manakjiri/lora-module-hw/lora-module.kicad_pcb

## KiCad design lora-module.kicad_pcb (2024-03-26)

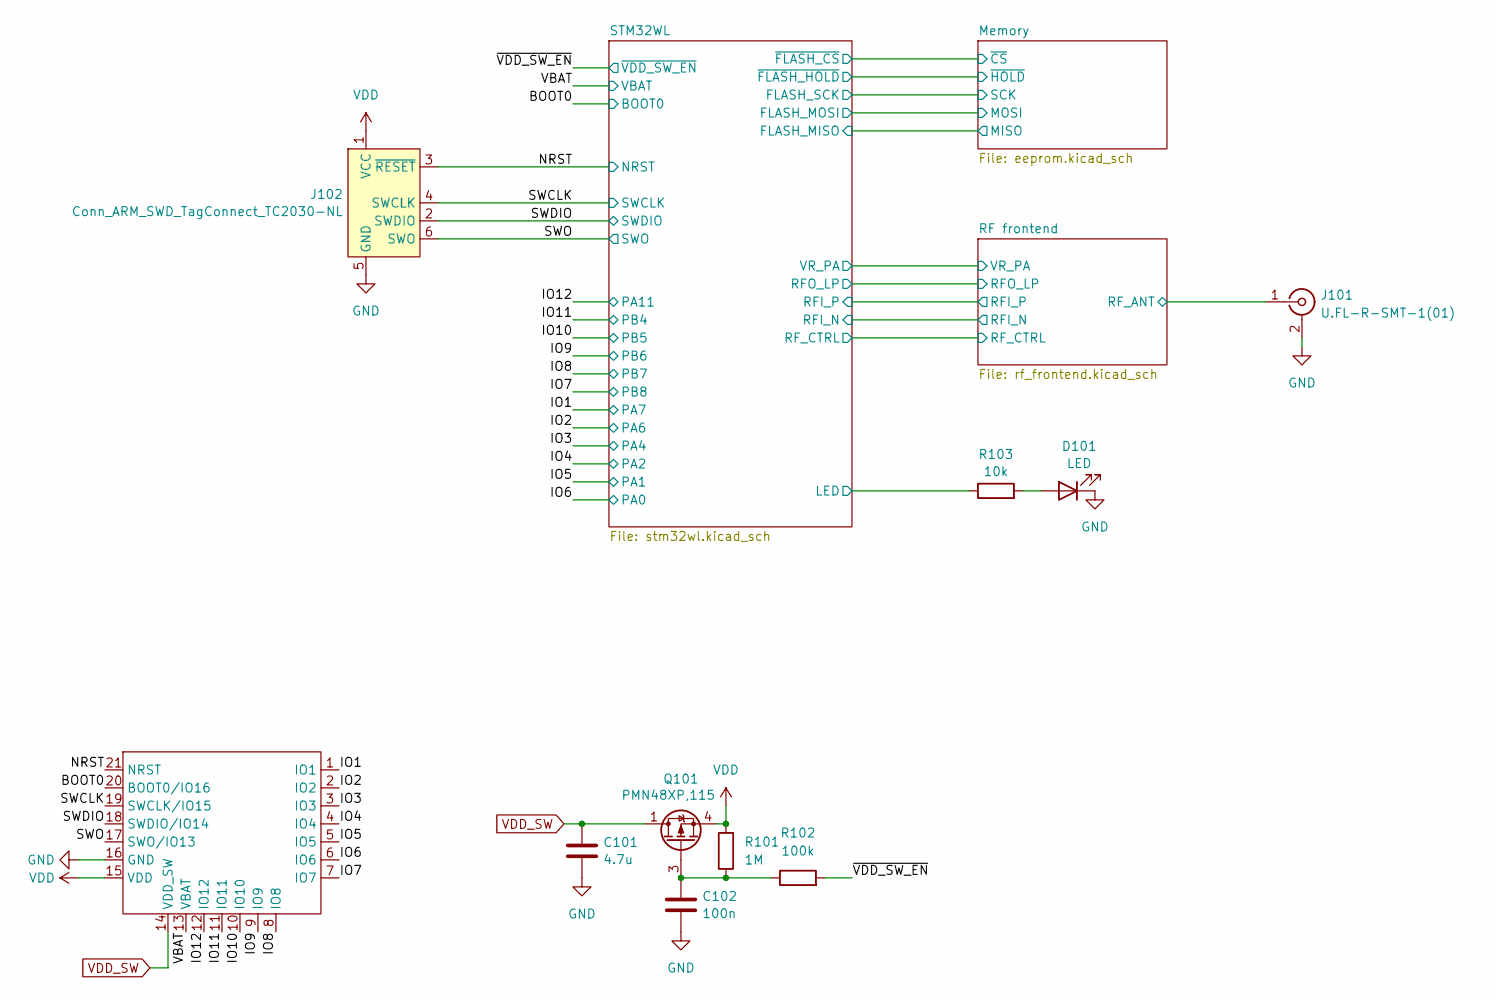
[picture p1: schematic lora-module.kicad_sch]

Parts:
C101: 4.7u; C_0603_1608Metric
C102: 100n; C_0402_1005Metric
D101: LED; LED_0402_1005Metric
J101: U.FL-R-SMT-1(01); U.FL_Hirose_U.FL-R-SMT-1_Vertical
J102: Conn_ARM_SWD_TagConnect_TC2030-NL; Tag-Connect_TC2030-IDC-NL_2x03_P1.27mm_Vertical
J106: module-connectors
Q101: PMN48XP,115; TSOP-6_1.65x3.05mm_P0.95mm
R101: 1M; R_0402_1005Metric
R102: 100k; R_0402_1005Metric
R103: 10k; R_0402_1005Metric

Connections:
/BOOT0: J106.20 (BOOT0/IO16); also elsewhere on the board
/IO1: J106.1 (IO1); also elsewhere on the board
/IO2: J106.2 (IO2); also elsewhere on the board
/IO3: J106.3 (IO3); also elsewhere on the board
/IO4: J106.4 (IO4); also elsewhere on the board
/IO5: J106.5 (IO5); also elsewhere on the board
/IO6: J106.6 (IO6); also elsewhere on the board
/IO7: J106.7 (IO7); also elsewhere on the board
/IO8: J106.8 (IO8); also elsewhere on the board
/IO9: J106.9 (IO9); also elsewhere on the board
/IO10: J106.10 (IO10); also elsewhere on the board
/IO11: J106.11 (IO11); also elsewhere on the board
/IO12: J106.12 (IO12); also elsewhere on the board
/NRST: J102.3 (~RESET), J106.21 (NRST); also elsewhere on the board
/RF frontend/RF_ANT: J101.1 (In); also elsewhere on the board
/STM32WL/LED: R103.1; also elsewhere on the board
/SWCLK: J102.4 (SWCLK), J106.19 (SWCLK/IO15); also elsewhere on the board
/SWDIO: J102.2 (SWDIO), J106.18 (SWDIO/IO14); also elsewhere on the board
/SWO: J102.6 (SWO), J106.17 (SWO/IO13); also elsewhere on the board
/VBAT: J106.13 (VBAT); also elsewhere on the board
/~VDD_SW_EN: R102.2; also elsewhere on the board
GND: C101.2, C102.2, D101.1 (K), J101.2 (Ext), J102.5 (GND), J106.16 (GND); also elsewhere on the board
unnamed: D101.2 (A), R103.2
unnamed: C102.1, Q101.3 (G), R101.1, R102.1
VDD: J102.1 (VCC), J106.15 (VDD), Q101.4 (S), R101.2; also elsewhere on the board
VDD_SW: C101.1, J106.14 (VDD_SW), Q101.1 (D), Q101.2 (D), Q101.5 (D), Q101.6 (D); also elsewhere on the board

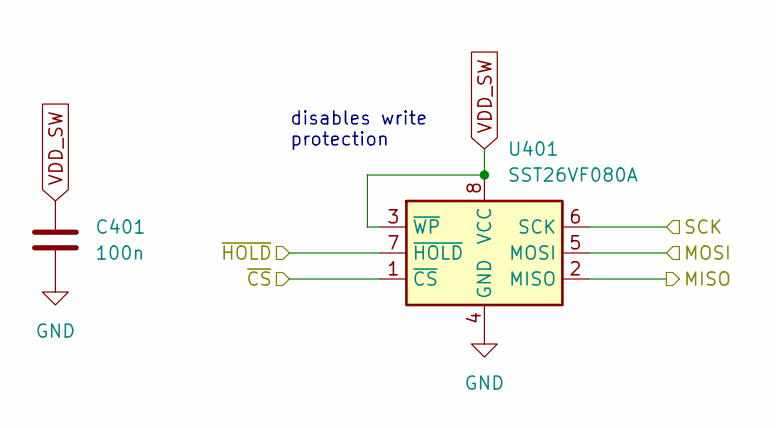
[picture p2: schematic eeprom.kicad_sch]

Parts:
C401: 100n; C_0402_1005Metric
U401: SST26VF080A; WDFN-8-1EP_6x5mm_P1.27mm_EP3.4x4mm

Connections:
/Memory/MISO: U401.2 (MISO); also elsewhere on the board
/Memory/MOSI: U401.5 (MOSI); also elsewhere on the board
/Memory/SCK: U401.6 (SCK); also elsewhere on the board
/Memory/~CS: U401.1 (~CS); also elsewhere on the board
/Memory/~HOLD: U401.7 (~HOLD); also elsewhere on the board
GND: C401.2, U401.4 (GND), U401.9 (GND); also elsewhere on the board
VDD_SW: C401.1, U401.3 (~WP), U401.8 (VCC); also elsewhere on the board

Notes on the sheet:
disables write protection

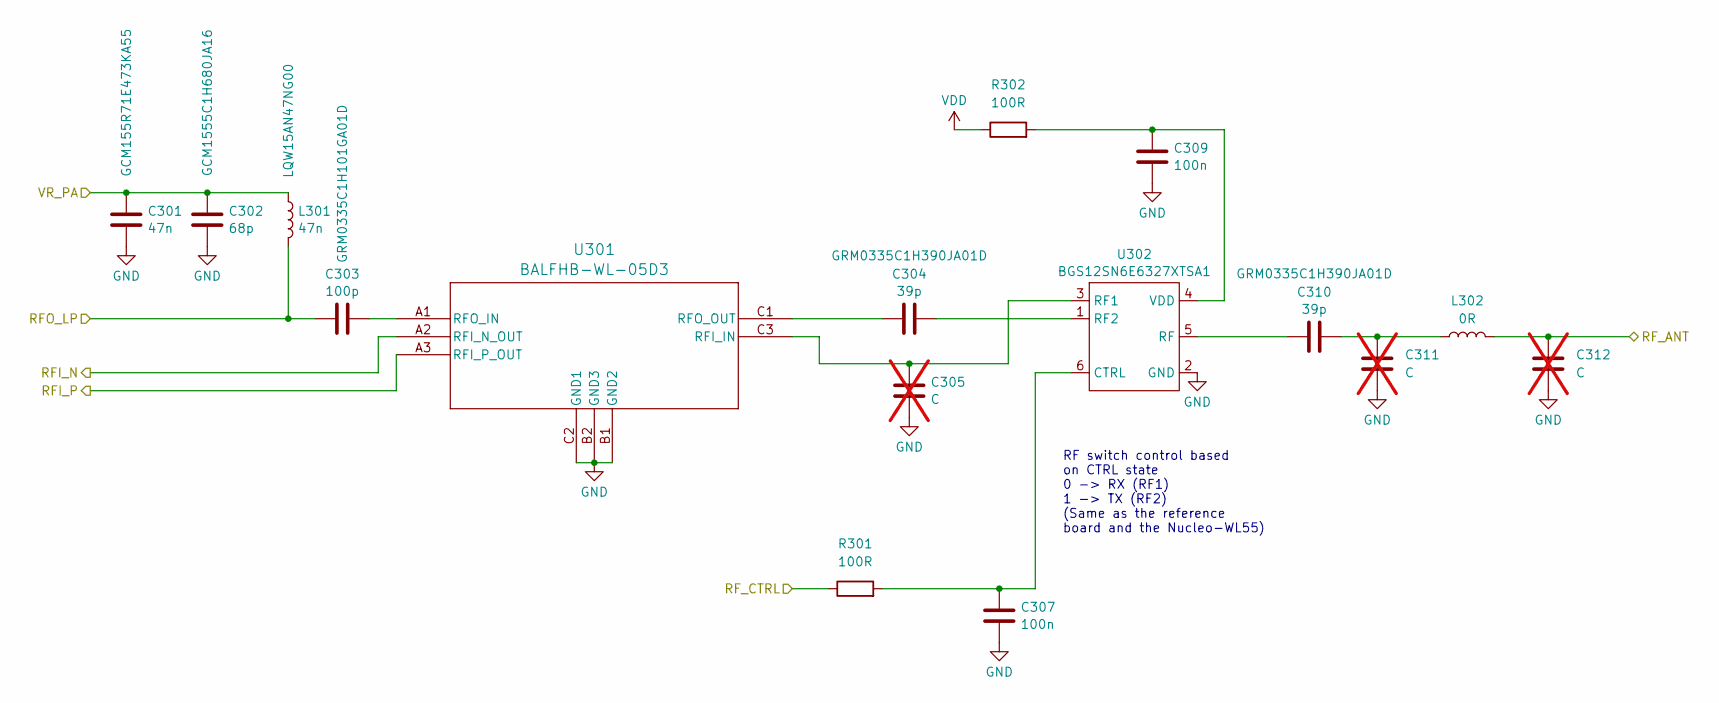
[picture p3: schematic rf_frontend.kicad_sch]

Parts:
C301: 47n; C_0603_1608Metric; Part GCM155R71E473KA55
C302: 68p; C_0402_1005Metric; Part GCM1555C1H680JA16
C303: 100p; C_0402_1005Metric; Part GRM0335C1H101GA01D
C304, C310: 39p; C_0402_1005Metric; Part GRM0335C1H390JA01D
C305, C311, C312: C; C_0402_1005Metric_Pad0.74x0.62mm_HandSolder; not fitted
C307, C309: 100n; C_0402_1005Metric
L301: 47n; L_0402_1005Metric; Part LQW15AN47NG00
L302: 0R; L_0402_1005Metric_Pad0.77x0.64mm_HandSolder
R301, R302: 100R; R_0402_1005Metric
U301: BALFHB-WL-05D3; BGA8_BALFHB_STM
U302: BGS12SN6E6327XTSA1; Infineon_PG-TSNP-6-10_0.7x1.1mm_0.7x1.1mm_P0.4mm

Connections:
/RF frontend/RFI_N: U301.A2 (RFI_N_OUT); also elsewhere on the board
/RF frontend/RFI_P: U301.A3 (RFI_P_OUT); also elsewhere on the board
/RF frontend/RFO_LP: C303.1, L301.2; also elsewhere on the board
/RF frontend/RF_ANT: C312.1, L302.2; also elsewhere on the board
/RF frontend/RF_CTRL: R301.1; also elsewhere on the board
/RF frontend/VR_PA: C301.1, C302.1, L301.1; also elsewhere on the board
GND: C301.2, C302.2, C305.2, C307.2, C309.2, C311.2, C312.2, U301.B1 (GND2), U301.B2 (GND3), U301.C2 (GND1), U302.2 (GND); also elsewhere on the board
unnamed: C310.2, C311.1, L302.1
unnamed: C305.1, U301.C3 (RFI_IN), U302.3 (RF1)
unnamed: C303.2, U301.A1 (RFO_IN)
unnamed: C304.1, U301.C1 (RFO_OUT)
unnamed: C307.1, R301.2, U302.6 (CTRL)
unnamed: C304.2, U302.1 (RF2)
unnamed: C310.1, U302.5 (RF)
unnamed: C309.1, R302.2, U302.4 (VDD)
VDD: R302.1; also elsewhere on the board

Notes on the sheet:
RF switch control based on CTRL state 0 -> RX (RF1) 1 -> TX (RF2) (Same as the reference board and the Nucleo-WL55)

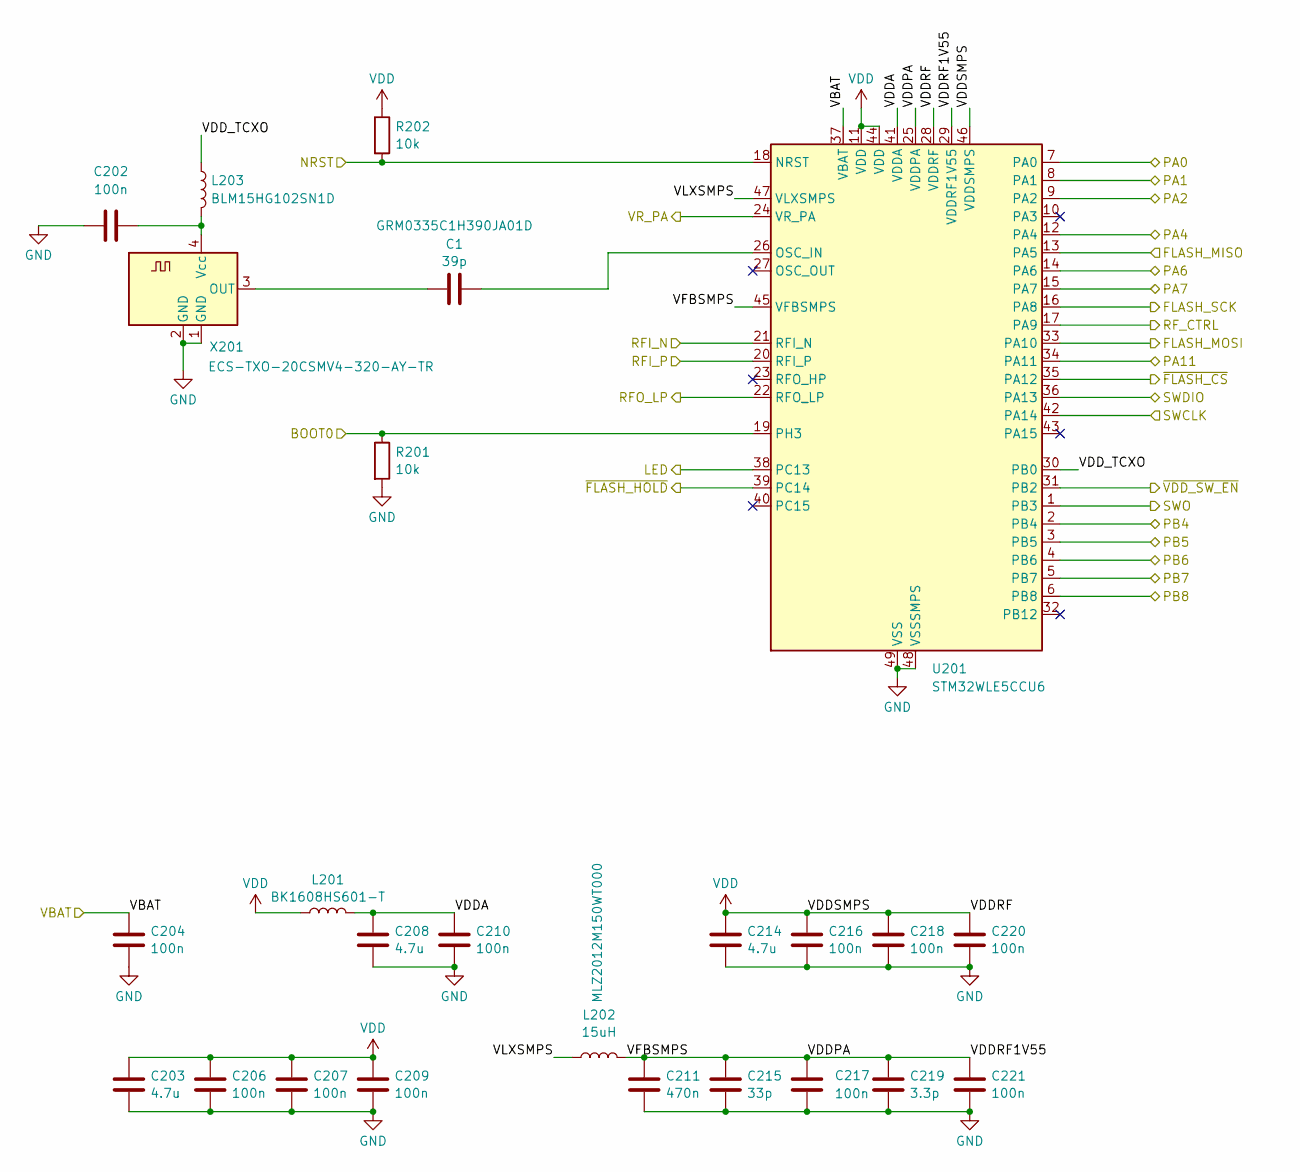
[picture p4: schematic stm32wl.kicad_sch]

Parts:
C1: 39p; C_0402_1005Metric; Part GRM0335C1H390JA01D
C202, C204, C206, C207, C209, C210, C216, C217, C218, C220, C221: 100n; C_0402_1005Metric
C203, C208, C214: 4.7u; C_0603_1608Metric
C211: 470n; C_0603_1608Metric
C215: 33p; C_0402_1005Metric
C219: 3.3p; C_0402_1005Metric
L201: BK1608HS601-T; L_0603_1608Metric
L202: 15uH; L_0805_2012Metric; Part MLZ2012M150WT000
L203: BLM15HG102SN1D; L_0402_1005Metric
R201, R202: 10k; R_0402_1005Metric
U201: STM32WLE5CCU6; QFN-48-1EP_7x7mm_P0.5mm_EP5.6x5.6mm
X201: ECS-TXO-20CSMV4-320-AY-TR; NX2016SA_NDK

Connections:
/BOOT0: R201.1, U201.19 (PH3); also elsewhere on the board
/IO1: U201.15 (PA7); also elsewhere on the board
/IO2: U201.14 (PA6); also elsewhere on the board
/IO3: U201.12 (PA4); also elsewhere on the board
/IO4: U201.9 (PA2); also elsewhere on the board
/IO5: U201.8 (PA1); also elsewhere on the board
/IO6: U201.7 (PA0); also elsewhere on the board
/IO7: U201.6 (PB8); also elsewhere on the board
/IO8: U201.5 (PB7); also elsewhere on the board
/IO9: U201.4 (PB6); also elsewhere on the board
/IO10: U201.3 (PB5); also elsewhere on the board
/IO11: U201.2 (PB4); also elsewhere on the board
/IO12: U201.34 (PA11); also elsewhere on the board
/Memory/MISO: U201.13 (PA5); also elsewhere on the board
/Memory/MOSI: U201.33 (PA10); also elsewhere on the board
/Memory/SCK: U201.16 (PA8); also elsewhere on the board
/Memory/~CS: U201.35 (PA12); also elsewhere on the board
/Memory/~HOLD: U201.39 (PC14); also elsewhere on the board
/NRST: R202.2, U201.18 (NRST); also elsewhere on the board
/RF frontend/RFI_N: U201.21 (RFI_N); also elsewhere on the board
/RF frontend/RFI_P: U201.20 (RFI_P); also elsewhere on the board
/RF frontend/RFO_LP: U201.22 (RFO_LP); also elsewhere on the board
/RF frontend/RF_CTRL: U201.17 (PA9); also elsewhere on the board
/RF frontend/VR_PA: U201.24 (VR_PA); also elsewhere on the board
/STM32WL/LED: U201.38 (PC13); also elsewhere on the board
/STM32WL/VDDA: C208.1, C210.1, L201.2, U201.41 (VDDA)
/STM32WL/VDDPA: C211.1, C215.1, C217.1, C219.1, C221.1, L202.2, U201.25 (VDDPA), U201.29 (VDDRF1V55), U201.45 (VFBSMPS)
/STM32WL/VDD_TCXO: L203.1, U201.30 (PB0)
/STM32WL/VLXSMPS: L202.1, U201.47 (VLXSMPS)
/SWCLK: U201.42 (PA14); also elsewhere on the board
/SWDIO: U201.36 (PA13); also elsewhere on the board
/SWO: U201.1 (PB3); also elsewhere on the board
/VBAT: C204.1, U201.37 (VBAT); also elsewhere on the board
/~VDD_SW_EN: U201.31 (PB2); also elsewhere on the board
GND: C202.1, C203.2, C204.2, C206.2, C207.2, C208.2, C209.2, C210.2, C211.2, C214.2, C215.2, C216.2, C217.2, C218.2, C219.2, C220.2, C221.2, R201.2, U201.48 (VSSSMPS), U201.49 (VSS), X201.1 (GND), X201.2 (GND); also elsewhere on the board
unnamed: C1.2, U201.26 (OSC_IN)
unnamed: C1.1, X201.3 (OUT)
unnamed: C202.2, L203.2, X201.4 (Vcc)
VDD: C203.1, C206.1, C207.1, C209.1, C214.1, C216.1, C218.1, C220.1, L201.1, R202.1, U201.11 (VDD), U201.28 (VDDRF), U201.44 (VDD), U201.46 (VDDSMPS); also elsewhere on the board

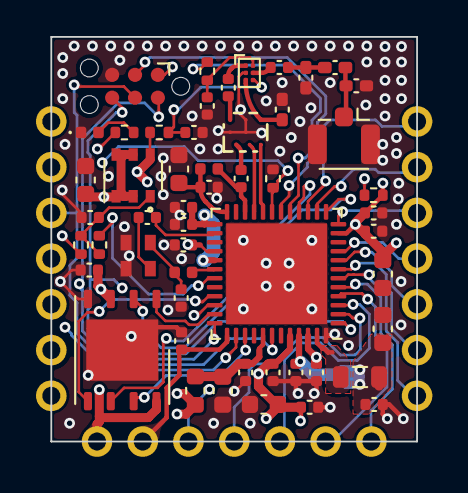
[picture p5: board lora-module.kicad_pcb from above]

Board: 4 copper layers, 20.3 x 22.5 mm, 53 parts (0 on the bottom side), 51 nets.
