manakjiri/lora-module-hw/st/lora-module-hw.ioc

Mcu.UserName=STM32WLE5CCUx
PA1.Signal=SPI1_SCK
PA10.Signal=SPI2_MOSI
PA12.GPIO_Label=FLASH_CS
PA12.Signal=GPIO_Output
PA13.Signal=DEBUG_JTMS-SWDIO
PA14.Signal=DEBUG_JTCK-SWCLK
PA5.Signal=SPI2_MISO
PA8.Signal=SPI2_SCK
PA9.GPIO_Label=RF_CTRL
PA9.Signal=GPIO_Output
PB0-VDD_TCXO.Signal=VDDTCXO
PB2.GPIO_Label=CDD_SW_NEN
PB2.Signal=GPIO_Output
PB3.Signal=DEBUG_JTDO-SWO
PB4.Signal=SPI1_MISO
PB5.Signal=SPI1_MOSI
PB7.Signal=I2C1_SDA
PB8.Signal=I2C1_SCL
PC13.GPIO_Label=LED_EN
PC13.Signal=GPIO_Output
PC14-OSC32_IN.GPIO_Label=FLASH_HOLD
PC14-OSC32_IN.Signal=GPIO_Output
