manakjiri/lora-module-hw/(commit log)

2023-10-14 working on the RF frontend
    [lora-module.kicad_pcb, lora-module.kicad_sch, rf_frontend.kicad_sch, stm32wl.kicad_sch]
2023-10-15 STM power mostly done
    [lora-module.kicad_sch, rf_frontend.kicad_sch, stm32wl.kicad_sch]
2023-10-17 added cubemx file for checking pinout
    [eeprom.kicad_sch, lora-module.kicad_pcb, lora-module.kicad_sch, rf_frontend.kicad_sch, stm32wl.kicad_sch]
2023-10-18 most components placed, routed the RF section
    [lora-module.kicad_pcb, lora-module.kicad_sch, rf_frontend.kicad_sch, stm32wl.kicad_sch]
2023-10-19 most of the components are placed
    [eeprom.kicad_sch, lora-module.kicad_pcb, lora-module.kicad_sch, rf_frontend.kicad_sch, stm32wl.kicad_sch]
2023-10-19 added tag-connect and a led, noticed i forgot a crystal
    [lora-module.kicad_pcb, lora-module.kicad_sch, rf_frontend.kicad_sch, stm32wl.kicad_sch]
2023-10-19 added the crystal
    [lora-module.kicad_pcb, stm32wl.kicad_sch]
2023-10-20 added castellated edge connectors
    [lora-module.kicad_pcb, lora-module.kicad_sch, stm32wl.kicad_sch]
2023-10-20 created a footprint for the edge connectors
    [lora-module.kicad_pcb, lora-module.kicad_sch, stm32wl.kicad_sch]
2023-10-22 mostly finishing, all IOs connected, drc clean
    [lora-module.kicad_pcb, lora-module.kicad_sch, stm32wl.kicad_sch]
2023-10-22 added teardrops, finishing touches
    [lora-module.kicad_pcb, lora-module.kicad_sch]
2023-10-23 added bottom silkscreen
    [lora-module.kicad_pcb]
2023-10-26 groundplane settings tweak
    [eeprom.kicad_sch, lora-module.kicad_pcb, lora-module.kicad_sch, rf_frontend.kicad_sch, stm32wl.kicad_sch]
2023-10-26 batter layout of the SMPS section
    [lora-module.kicad_pcb]
2023-10-28 bom tweaks
    [lora-module.kicad_pcb, stm32wl.kicad_sch]
2023-11-27 hw: after manufacturing
    [lora-module.kicad_pcb]
2024-03-02 stm32cubeide project for cross-checking
2024-03-07 changed XO to TCXO
    [lora-module.kicad_pcb, lora-module.kicad_sch, rf_frontend.kicad_sch, stm32wl.kicad_sch]
2024-03-08 small tweaks
    [lora-module.kicad_pcb]
2024-03-26 module pinout change
    [lora-module.kicad_pcb, lora-module.kicad_sch, stm32wl.kicad_sch]
2024-03-26 bom update and other tweaks
    [eeprom.kicad_sch, lora-module.kicad_pcb, lora-module.kicad_sch, rf_frontend.kicad_sch, stm32wl.kicad_sch]
